jackshiels/PlantMonitor/Images/bell.jpeg

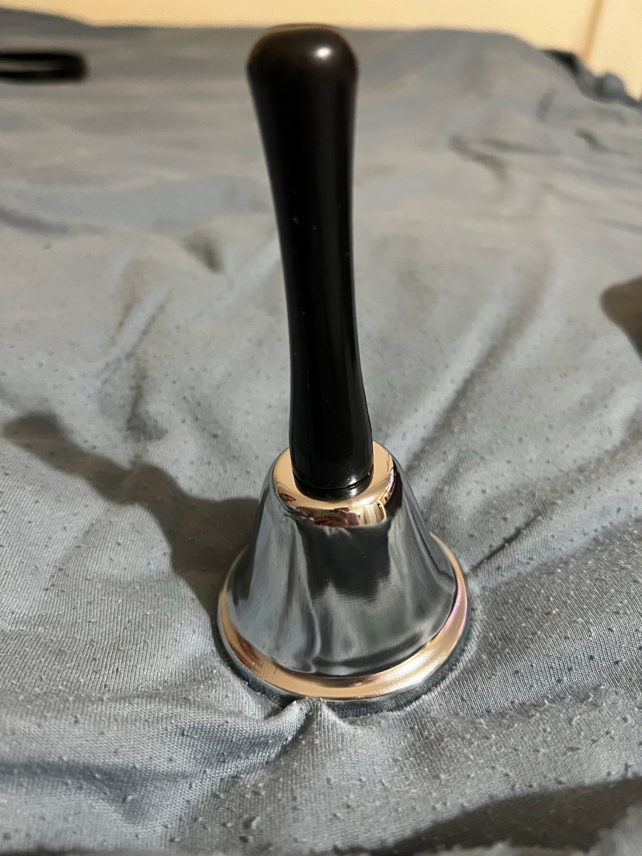
Images/bell.jpeg
