jackshiels/PlantMonitor/Images/FritzDiagram.png

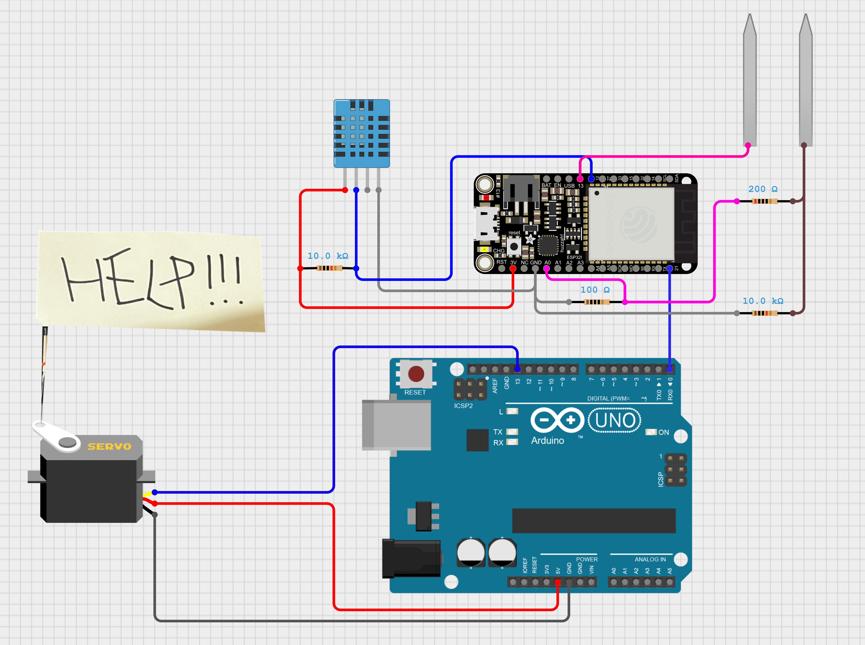
Images/FritzDiagram.png
