jackshiels/PlantMonitor/Images/grafana.jpg

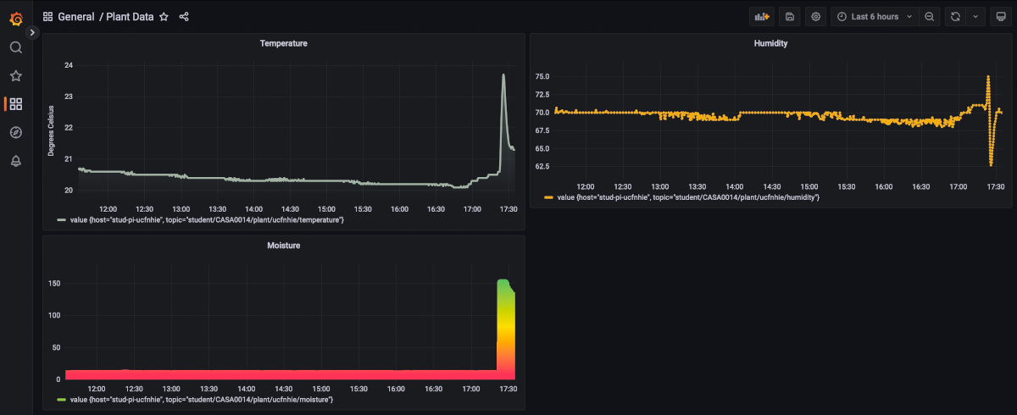
Images/grafana.jpg
