jackshiels/PlantMonitor/Images/mockup.jpeg

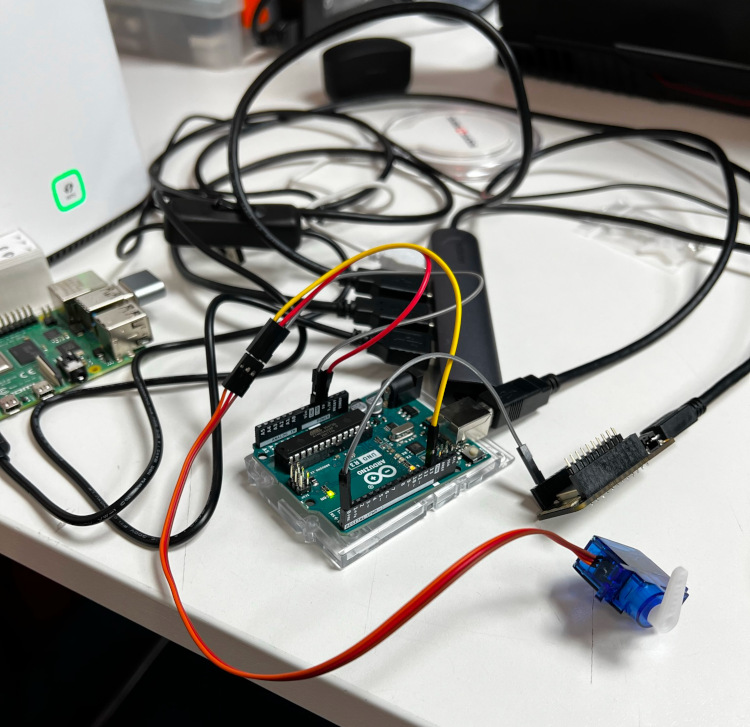
Images/mockup.jpeg
