jackshiels/PlantMonitor/Images/mqtt.jpg

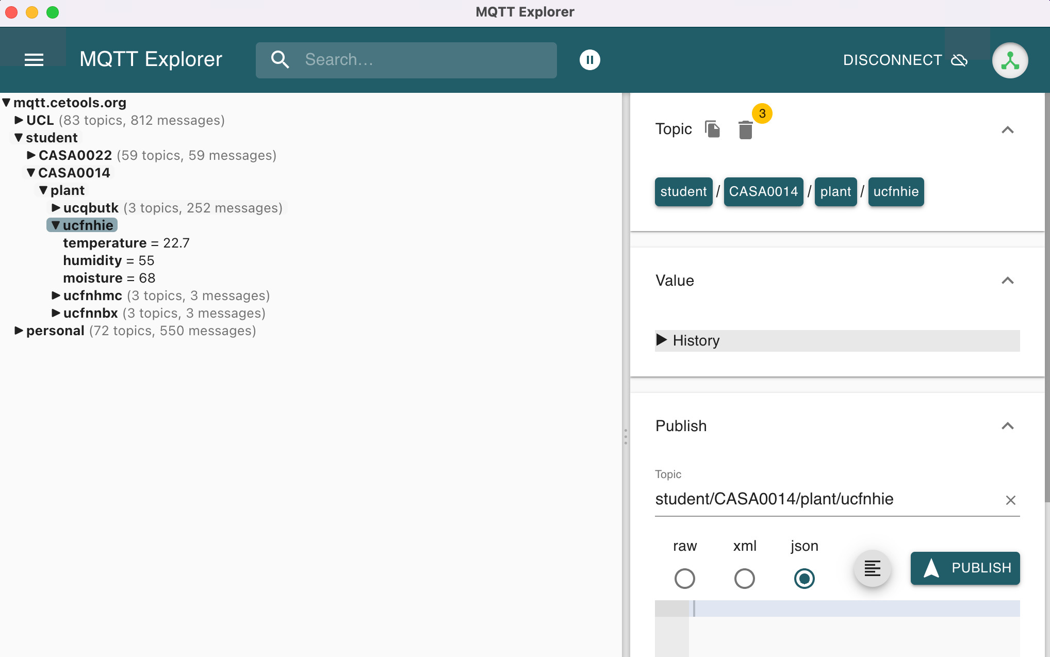
Images/mqtt.jpg
