jackshiels/PlantMonitor/Images/sketches.jpeg

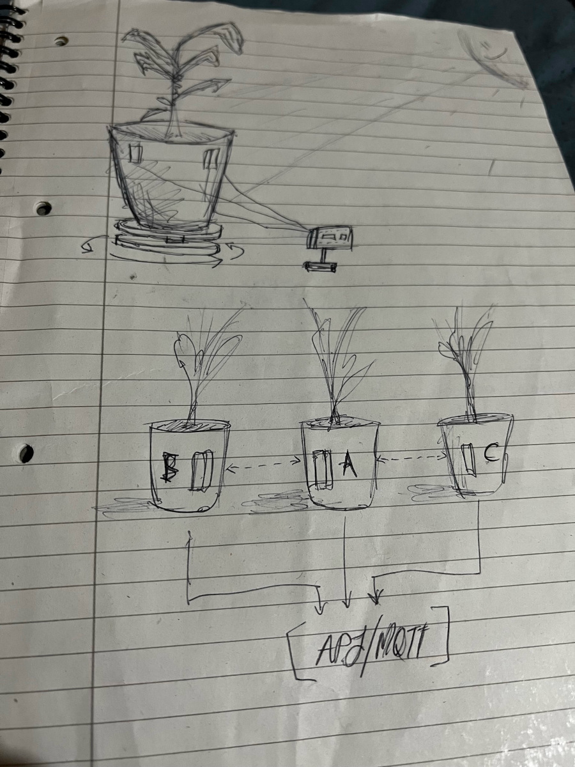
Images/sketches.jpeg
