jackshiels/PlantMonitor/Images/soldering.jpeg

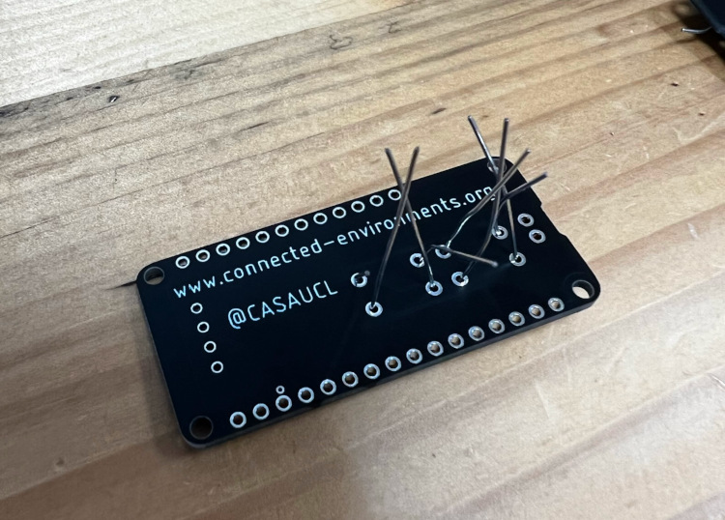
Images/soldering.jpeg
