jackshiels/PlantMonitor/(commit log)

2022-10-27 Added main plant monitor script
    Added the main plant monitor script, which includes the broadcast logic for MQTT feeds based on soil resistance and temperature/humidity sensing.
2022-10-29 Refactored DHT sensor readings code
2022-10-29 Added the initial servo and serial scripts
2022-10-31 Added the new Arduino script
2022-11-11 updated readme with more detailed schematics
2022-11-12 Added custom MQTT broker
    [FlagReceiverMain.ino, PlantMonitorMain.ino]
